PogValGen/robo-boxer/README.md

# robo-boxer — робот-боксёр на MG90S (ROBO-ONE Light)

Открытый DIY-проект миниатюрного двуногого робота-боксёра: сервоприводы MG90S, ШИМ-контроллер на 32 канала (в наличии RTrobot Sync 32 кан., skill `rtrobot`; в ТЗ — PCA9685 ×2), IMU MPU-6050, раздельное питание (BEC 5 В / 8–10 А). Исходное ТЗ: `docs/notes/2026-10-31_robo_one_boxing_spec.md`.

## Статус

| Узел | Состояние |
|---|---|
| Узел разгрузки сустава (685ZZ + ось 623ZZ, карман MG90S +0,2) | **v0.2** 2026-10-31 (рёбра + облегчение; v0.1 в `cad/joint_v01/`): `cad/joint/Joint_MG90S.SLDASM`, STL печатных деталей `cad/joint/stl/`, сценарий `scripts/build_joint.py` |
| Сервопривод MG90S | модель GrabCAD (`cad/purchased/`); гнездо 23,2×13,0 — подобрано пользователем (Голень.stl); качалка — типовые размеры (приняты); кабель выходит снизу из торца со стороны вала (фото Racerstar MG90S) (`docs/notes/mg90s_measure_checklist.md`) |
| Нога: бедро-крен H1 (повёрнут 90°) → бедро-тангаж → колено → голеностоп + стопа с грузом | **v0.1** 2026-10-31: `cad/leg/Leg_Pitch.SLDASM`, `scripts/build_leg.py` |
| Таз + поворот корпуса W + площадка торса; сборка низа робота | **v0.1** 2026-10-31: `cad/body/Robot_Lower.SLDASM`, `scripts/build_pelvis.py` |
| 3D-просмотр (Android/браузер) | `docs/viewer/robot_3d.html` ← `scripts/make_viewer.py` |
| Руки (S1 → S2 повёрнут → E + кулак TPU), плечевая перекладина, весь робот | **v0.1** 2026-10-31: `cad/arm/Arm.SLDASM`, `cad/body/Robot.SLDASM`, `scripts/build_arm.py` |
| Торс (оболочка), голова-бампер, электроника | не начато |
| Электроника, прошивка (IK, PD-баланс, UART) | не начато |

## Структура

- `cad/` — модели SolidWorks (детали, сборки, STL для печати)
- `scripts/` — сценарии построения через solidworks-mcp
- `docs/` — материалы (индекс `docs/MATERIALS.md`)

## Связанные проекты

- **solidworks-mcp** — инструменты построения (Toolbox, Hole Wizard, сопряжения).
- **pcb-kicad** — если понадобится своя плата распределения питания/ШИМ.

## Узел сустава v0.2 (2026-10-31)

Схема силового потока: удар по рычагу → цапфа Ø5 → 685ZZ в мосту → стойка корпуса; нижняя щека → штифт ISO 2338 3×8 → 623ZZ в бобышке корпуса. Вал сервы получает только момент через качалку, утопленную в карман щеки (+0,2).

| Деталь | Материал | Габарит, мм | Объём |
|---|---|---|---|
| Joint_Housing (гнездо MG90S, стойка с 2 рёбрами-косынками, бобышка 623, выборка снизу) | ABS/PETG | 38,5 × 43,6 × 18 | 9180 мм³ (v0.1: 9644) |
| Joint_Bridge (гнездо 685, 2×M2 к стойке, швеллер: рёбра 2,5 + дно 2,5) | ABS/PETG | 36,5 × 6,5 × 18 | 2655 мм³ (v0.1: 3435) |
| Joint_Lever (U-рычаг, цапфа Ø5, штифт, 4×M2, окно в нижней щеке, карман в верхней) | ABS/PETG | 35 × 53,1 × 14 | 5058 мм³ (v0.1: 5658) |
| Подшипники 685ZZ, 623ZZ; штифт 3×8 | Toolbox ISO 15 / ISO 2338 | — | — |

Итого печать 16,9 см³ (−10 % к v0.1): сплошной ABS ≈ 17,7 г, при обычной печати (3 периметра, 30 % заполнения) ≈ 11 г + подшипники/штифт ≈ 3 г. Качалка — типовые размеры, приняты пользователем.

Кабель: паз в торце со стороны вала → плоский канал 1,8 мм под сервой → выход в торце −x (сектор, куда рычаг не заходит).

Сборка узла (v0.3): 1) MG90S в гнездо, саморезы M2 в ушки; 2) рычаг сначала прикрутить к торцу СЛЕДУЮЩЕГО корпуса (4 винта M2 с внутренним шестигранником изнутри U, пока U пустой); 3) качалку вложить в карман щеки и прикрутить 2 саморезами; 4) рычаг с качалкой надвинуть сбоку на 3,6 мм выше вала, опустить на шлицы (центральный винт качалки не нужен — рычаг зажат между подшипниками); 5) 623 запрессовать в бобышку, штифт 3×12 снизу через щеку в 623; 6) 685 в мост, мост на цапфу, 2×M2 в стойку. Ход ≈ ±140°.

## Нога v0.1 (2026-10-31)

Три узла в линию (бедро-тангаж H2, колено K, голеностоп A), шаг осей **55,5 мм**: перемычка рычага = торец следующего корпуса. Стопа 80 × 52 × 8 (ABS) на рычаге голеностопа, снизу карман под стальной груз **60 × 40 × 3** (≈56 г, на клей). От оси бедра до подошвы 147 мм. Пересечений нет (только касания ушек сервы). Бедро-крен H1 — тот же узел, повёрнут на 90° (стык 4×M2 квадратом ±4,5 подходит при повороте). Все 4 узла — один файл `Joint_MG90S.SLDASM`: правка узла сразу во всех. Дальше: таз (крепление H1 обеих ног + поворот W).

## Низ робота v0.1 (2026-10-31)

Система координат робота = ноги: x вниз, y вбок, z вперёд. Ноги на y = ±50 (стойка 100 мм). Таз: плита 124 × 52 × 6, к узлам H1 по 4×M2 сверху (Hole Wizard); сзади стойка с 2 косынками, на ней узел W (ось вертикальна), винты 4×M2 сзади. На рычаге W — площадка торса 90 × 67 (Г-образная). Всего 9 узлов = 9 × MG90S. Пересечений нет (18 касаний ушек сервы, объём 0).

3D: `python scripts\make_viewer.py` → HTML с three.js внутри (6 МБ), открывается на телефоне без интернета; положения деталей сверены с SolidWorks (76/76).

## Робот целиком v0.1 (2026-10-31)

15 узлов = 15 × MG90S (ноги 2 × 4, W, руки 2 × 3). Перекладина плеч 256 × 52 × 6 на площадке торса (4×M2), плечи на y = ±116 (ближе — руки задевают ноги). Рука: S1 (тангаж) → S2 (крен, узел повёрнут 90°) → локоть E → кулак TPU 30 × 32 × 32 (R6). Пересечений нет (30 касаний ушек, объём 0). Габарит ≈ 290 (ширина) × 310 (высота) мм — ширину даёт узел (60 мм по оси); резерв: повернуть S1 так, чтобы узел стоял узкой стороной.
