PogValGen/robo-boxer/docs/notes/2026-10-31_robo_one_boxing_spec.md

# Техническая документация: Проект антропоморфного робота-боксера на базе сервоприводов MG90S

## 1. Введение и концепция проекта
Данный документ обобщает технические решения, архитектурные концепции и спецификации для создания открытого DIY-проекта миниатюрного двуногого робота-боксера (гуманоида/полугуманоида). Проект адаптирован под жесткие ограничения соревнований класса **ROBO-ONE / ROBO-ONE Light**, регламентирующих вес, габариты и автономность мобильных человекоподобных роботов.

**Ключевая цель проекта:** Создание устойчивого, ударопрочного робота для ведения ближнего боя (бокс/ближний захват), способного наносить динамические удары за счет инерции корпуса и сохранять равновесие при встречных столкновениях.

---

## 2. Аппаратная спецификация (BOM & Электроника)
Для реализации системы используется готовый сетап комплектующих начального и полупрофессионального уровня:

*   **Силовые приводы (Сервоприводы):** Цифровые микросервоприводы **MG90S** (9g, металлический редуктор, крутящий момент ~1.8–2.2 кгф·см при 4.8V–6.0V). 
*   **Управляющий контроллер:** Специализированная плата расширения на **32 канала** управления ШИМ (PWM/Servo driver, например, на базе каскада микросхем PCA9685 или автономного USB/UART контроллера).
*   **Датчики стабилизации:** IMU-сенсор (гироскоп + акселерометр) **MPU-6050**, подключенный по шине I2C к мастер-контроллеру для вычисления углов наклона и динамического удержания баланса в реальном времени.
*   **Система питания:** Силовые цепи сервоприводов изолированы от цепей питания логики микроконтроллера. Рекомендуется выделенный DC-DC импульсный понижающий преобразователь (BEC) с параметрами **5V / 8-10A** пикового тока.

---

## 3. Кинематическая схема робота-боксера
Для компенсации невысокого крутящего момента сервоприводов MG90S классическая антропоморфная геометрия изменена в пользу «приземистого» полугуманоидного шасси с низким центром тяжести.

### Распределение степеней свободы (DoF):
1.  **Торс и таз (1 DoF):** Сервопривод скручивания корпуса влево/вправо в плоскости горизонта. Обеспечивает передачу момента от ног к плечевому поясу для генерации силы удара (хуки/апперкоты).
2.  **Плечевой узел (2 DoF на руку):** 
    *   *Ось X:* Подъем/опускание всей руки (апперкоты, защита головы).
    *   *Ось Y:* Выброс руки вперед (прямые удары, джебы).
3.  **Локтевой сустав (1 DoF на руку):** Сгибание предплечья для удержания боксерской стойки и блокирования ударов соперника.
4.  **Нижнее шасси (Ноги, 6–8 DoF):** Укороченные рычаги бедер и голеней, широкая расстановка стоп (Wide Stance) для пассивной поперечной устойчивости.

---

## 4. Защита механизмов и 3D-печать (SolidWorks CAD)
Главная инженерная уязвимость сервоприводов MG90S при ударных нагрузках — хрупкость выходного вала (4.8 мм) и пластиковых проушин корпуса. Вся ударная волна от кулака робота должна уходить на внешний силовой каркас, минуя редуктор мотора.

### Техническое задание для моделирования узла разгрузки в SolidWorks:
*   **Соосная разгрузка вала:** Деталь плеча/предплечья базируется на силовом радиальном мини-подшипнике (например, **685ZZ** с внутренним диаметром 5 мм или **623ZZ**), запрессованном в печатный стакан корпуса. Вал сервопривода соединяется с деталью исключительно через гибкую шлицевую муфту (качалку), передавая только вращательный момент.
*   **Опорная точка (Ленивец):** На противоположной стороне сустава проектируется соосная гладкая ось вращения (простой штифт или второй подшипник) для предотвращения перекосов и скручивания конструкции при боковых ударах.
*   **FDM Допуски под печать:** Номинальные размеры кармана под установку MG90S в SolidWorks закладываются с технологическим зазором **+0.2 мм** на каждую сторону (для компенсации усадки пластиков ABS/PETG).
*   **Снижение веса и демпфирование:**
    *   Верхняя часть корпуса (торс, руки) моделируется с тонкими стенками (2-2.5 мм) и внутренними ребрами жесткости (*Ribs*).
    *   Кулаки и защитные накладки проектируются под печать гибкими пластиками (**TPU/Flex**) для гашения энергии встречного удара.
    *   Элементы стоп утяжеляются металлическими закладными элементами (гарантия эффекта «неваляшки»).

---

## 5. Программный уровень и алгоритмы
*   **Инверсная кинематика (IK):** Расчет траектории перемещения стоп для плавного шага без отрыва центра тяжести от опорной площади.
*   **Система стабилизации:** Коррекция ШИМ-сигналов на сервоприводы голеностопа по пропорционально-дифференциальному (PD) алгоритму на основе данных угловых скоростей с MPU-6050.
*   **Интерфейс управления:** Движения активируются по протоколу UART (последовательные команды) через Bluetooth-модуль или внешний контроллер верхнего уровня.
