PogValGen/robo-boxer/docs/notes/2026-10-31_mg90s_dimensions_sources.md

# MG90S — источники размеров (2026-10-31)

Официального механического чертежа TowerPro MG90S в открытом доступе не найдено.

| Параметр | Значение | Источник | Статус |
|---|---|---|---|
| Корпус L×W×H | 22,8 × 12,2 × 28,5 мм | GetFPV, CoolComponents (большинство продавцов) | проверить |
| Корпус (альт.) | 22,5 × 12 × 35,5 мм | Controllerstech (вероятно, с валом) | расхождение |
| Крепёжные отверстия | 2 × M2, шаг ~8 мм (?) | блог KPower — вторичный | НЕ подтверждено |
| Вал | Ø4,8 мм (шлицы) | ТЗ пользователя | проверить число зубьев |
| Совместимость | «крепёж как у SG90» | ReadyMadeRC | не подтверждено |

URL:
- https://www.getfpv.com/towerpro-mg90s-digital-servo.html
- https://coolcomponents.co.uk/products/mg90s-analog-metal-gear-servo
- https://shop.controllerstech.com/products/mg90s-metal-gear-9g-digital-servo-motor-180-deg
- https://blog.kpower.com/servo/631.html
- https://readymaderc.com/products/details/86506-towerpro-mg90s-metal-gear-servo-90-degree-rotation

Вывод: модель MG90S параметрическая (`cad/mg90s_params.json`), всё помечено `verify`; окончательные размеры — по замеру (чеклист `mg90s_measure_checklist.md`).
