PogValGen/robo-boxer/cad/joint/screens/asm_front.png

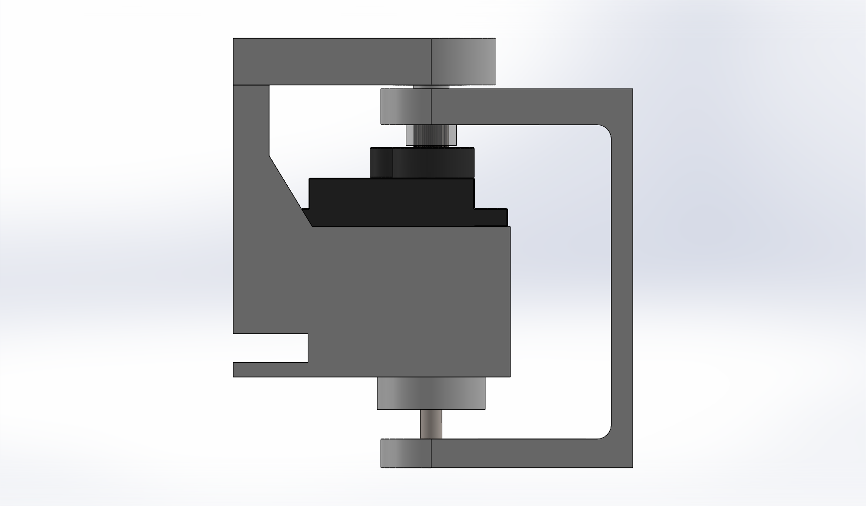
cad/joint/screens/asm_front.png
