PogValGen/robo-boxer/cad/joint/screens/asm_right.png

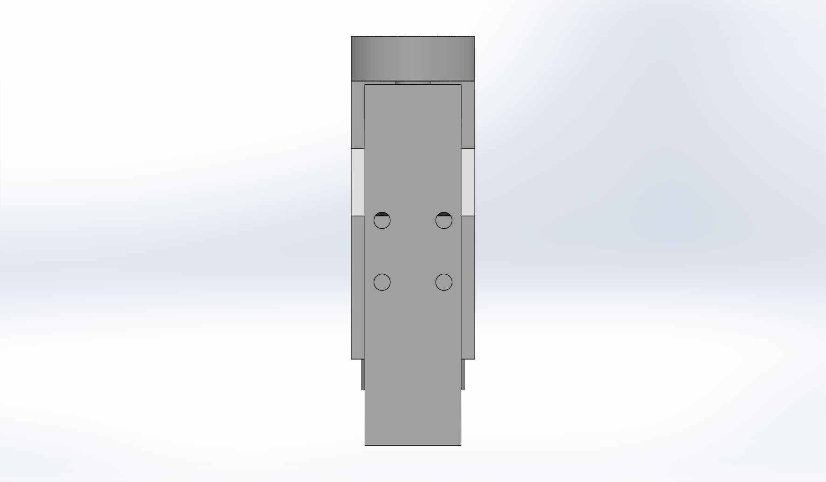
cad/joint/screens/asm_right.png
