PogValGen/robo-boxer/cad/joint/screens/asm_top.png

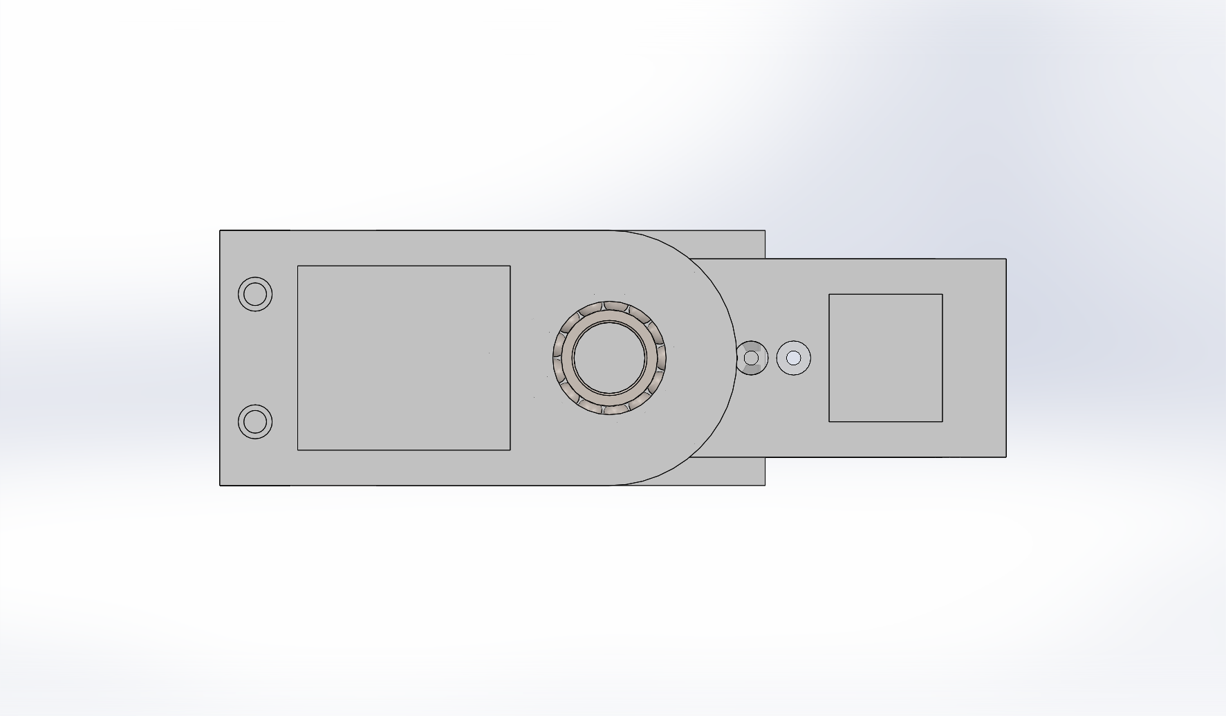
cad/joint/screens/asm_top.png
