PogValGen/robo-boxer/cad/joint/screens/bridge_iso.png

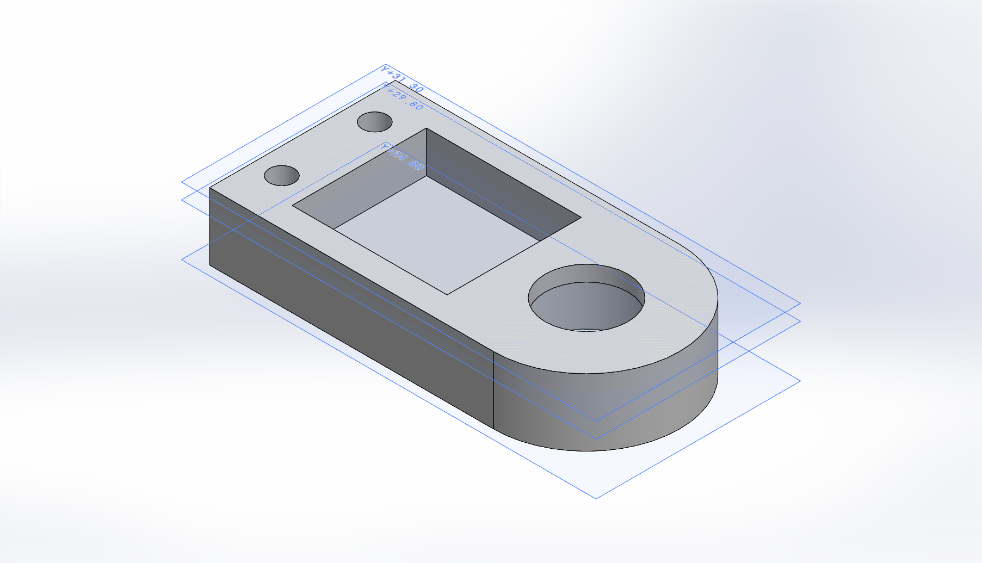
cad/joint/screens/bridge_iso.png
