PogValGen/robo-boxer/cad/joint/screens/fist_iso.png

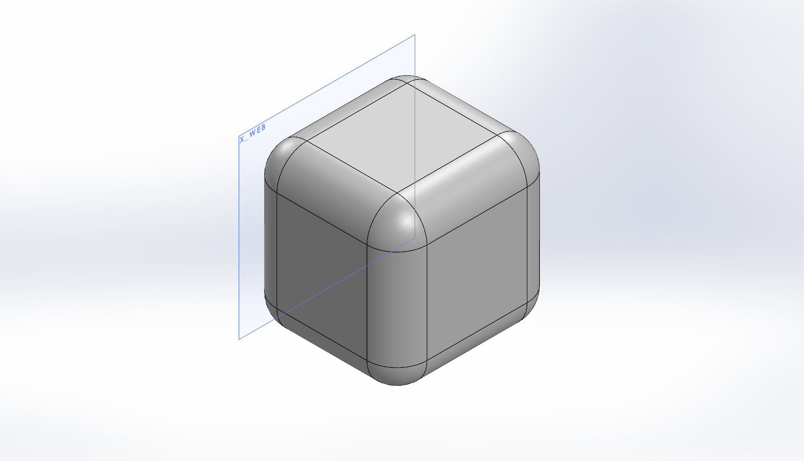
cad/joint/screens/fist_iso.png
