PogValGen/robo-boxer/cad/joint/screens/foot_iso.png

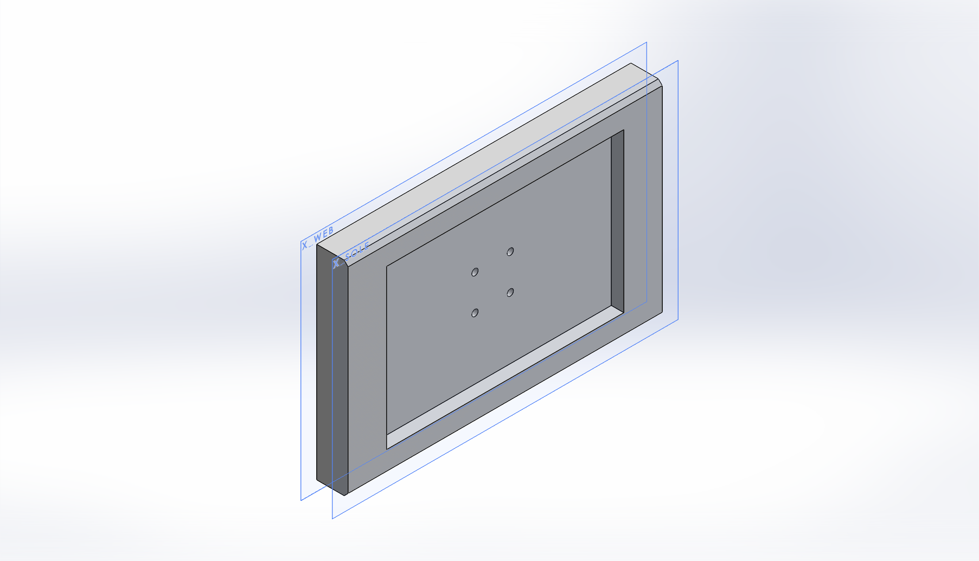
cad/joint/screens/foot_iso.png
