PogValGen/robo-boxer/cad/joint/screens/horn_iso.png

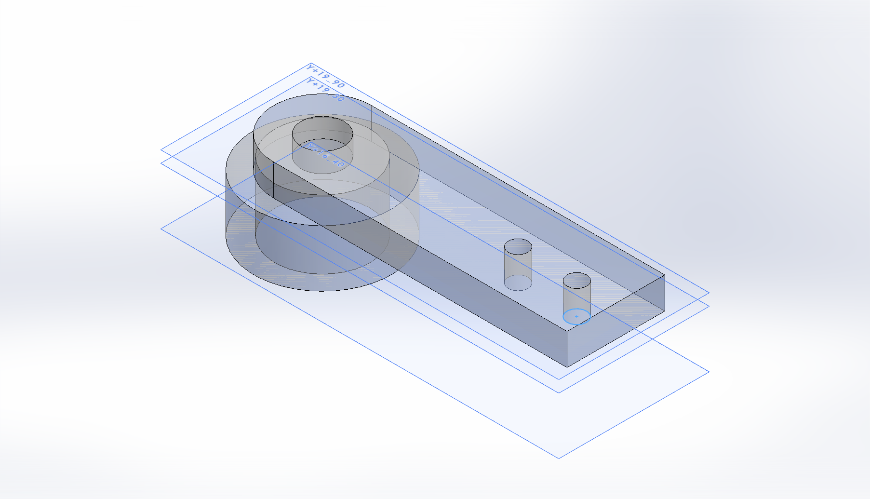
cad/joint/screens/horn_iso.png
