PogValGen/robo-boxer/cad/joint/screens/leg_front.png

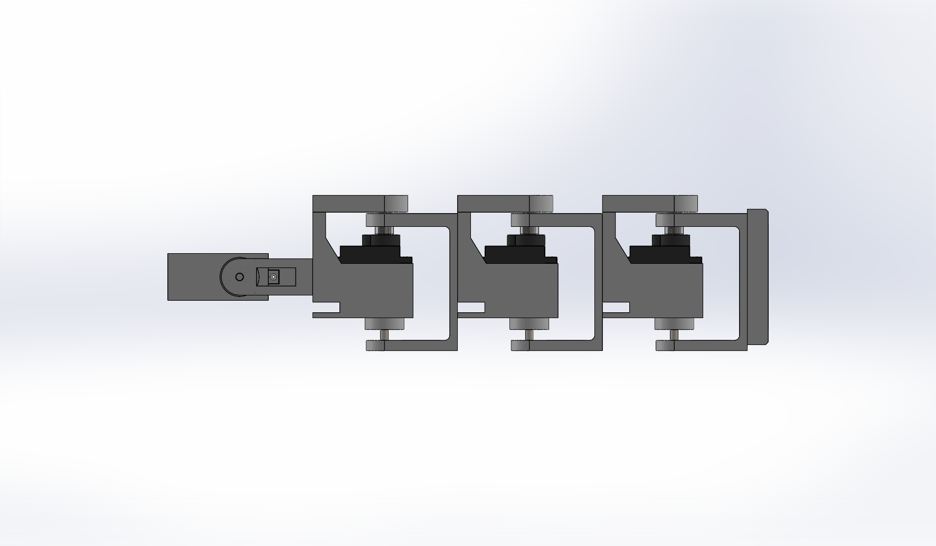
cad/joint/screens/leg_front.png
