PogValGen/robo-boxer/cad/joint/screens/leg_isometric.png

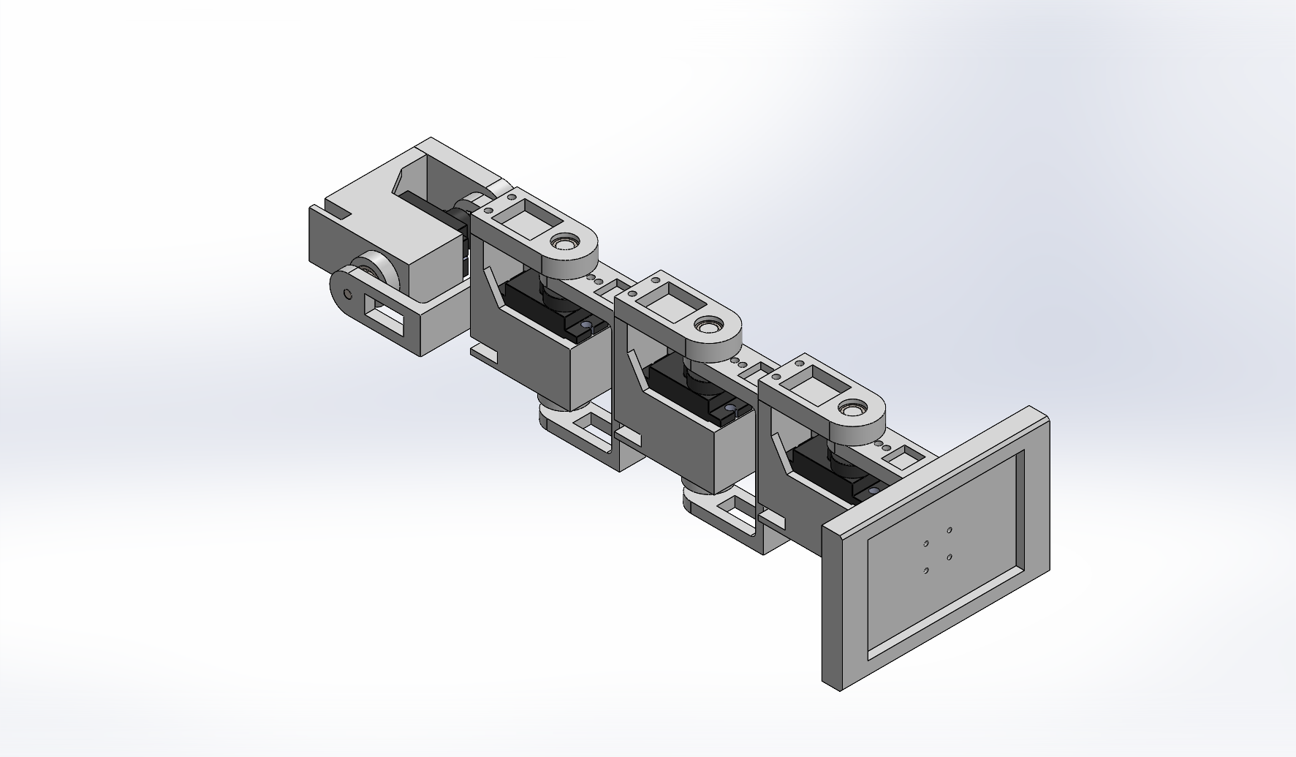
cad/joint/screens/leg_isometric.png
