PogValGen/robo-boxer/cad/joint/screens/leg_right.png

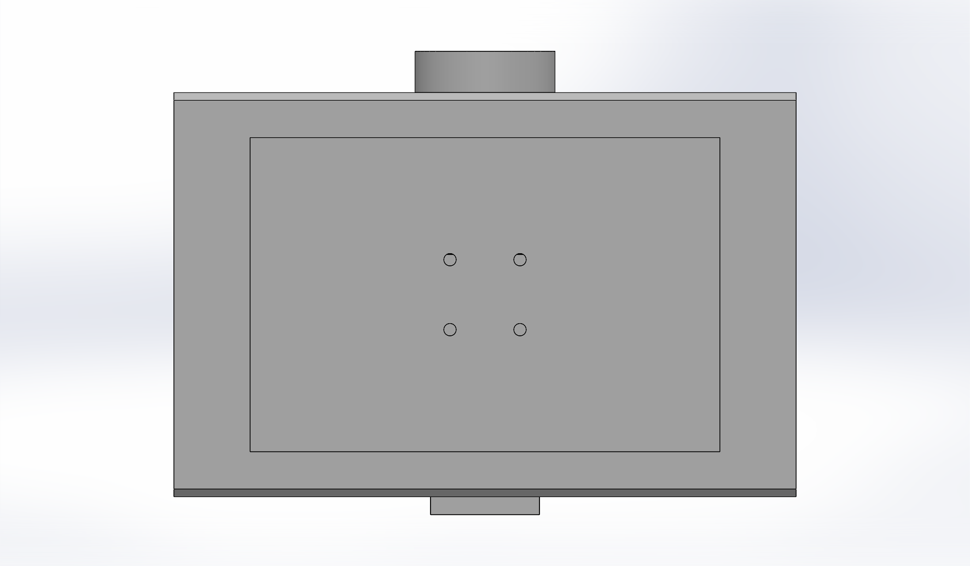
cad/joint/screens/leg_right.png
