PogValGen/robo-boxer/cad/joint/screens/leg_top.png

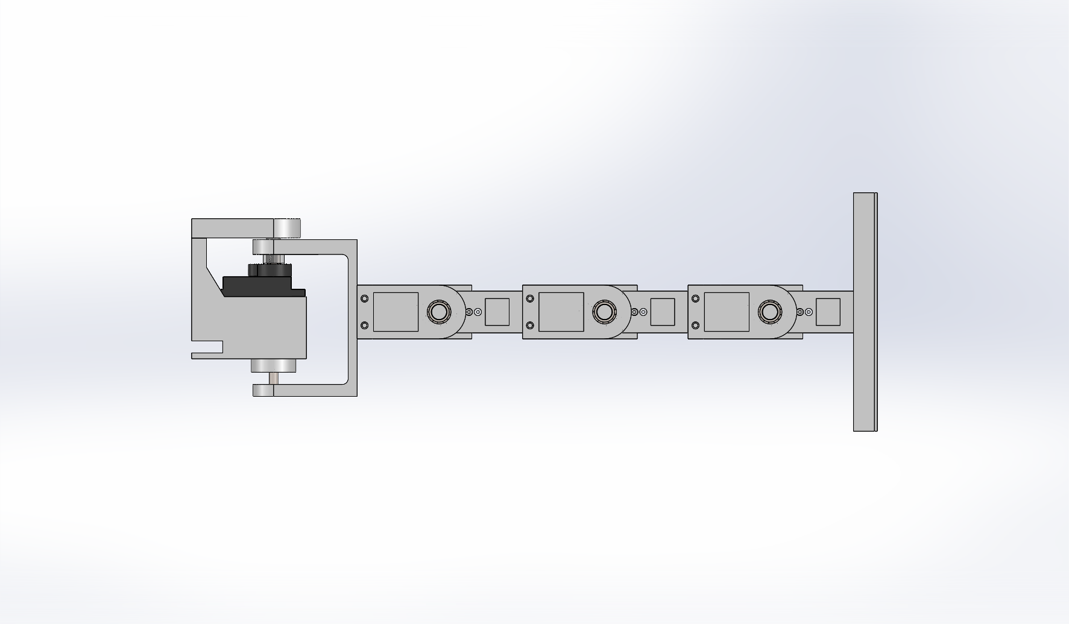
cad/joint/screens/leg_top.png
