PogValGen/robo-boxer/cad/joint/screens/lever_iso.png

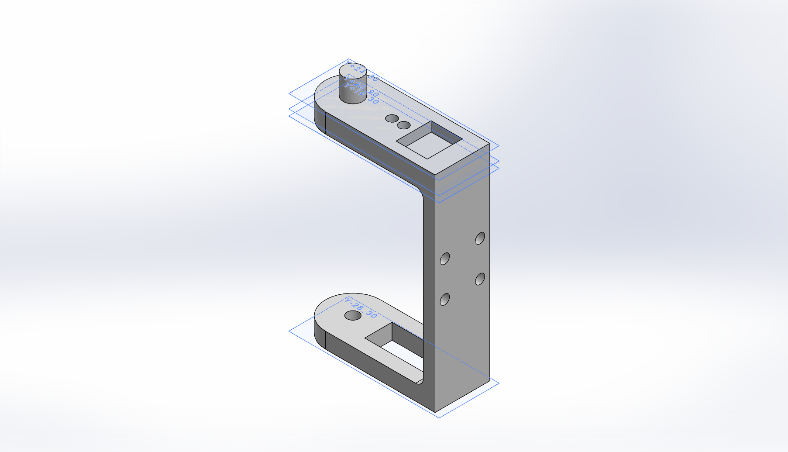
cad/joint/screens/lever_iso.png
