PogValGen/robo-boxer/cad/joint/screens/lower_front.png

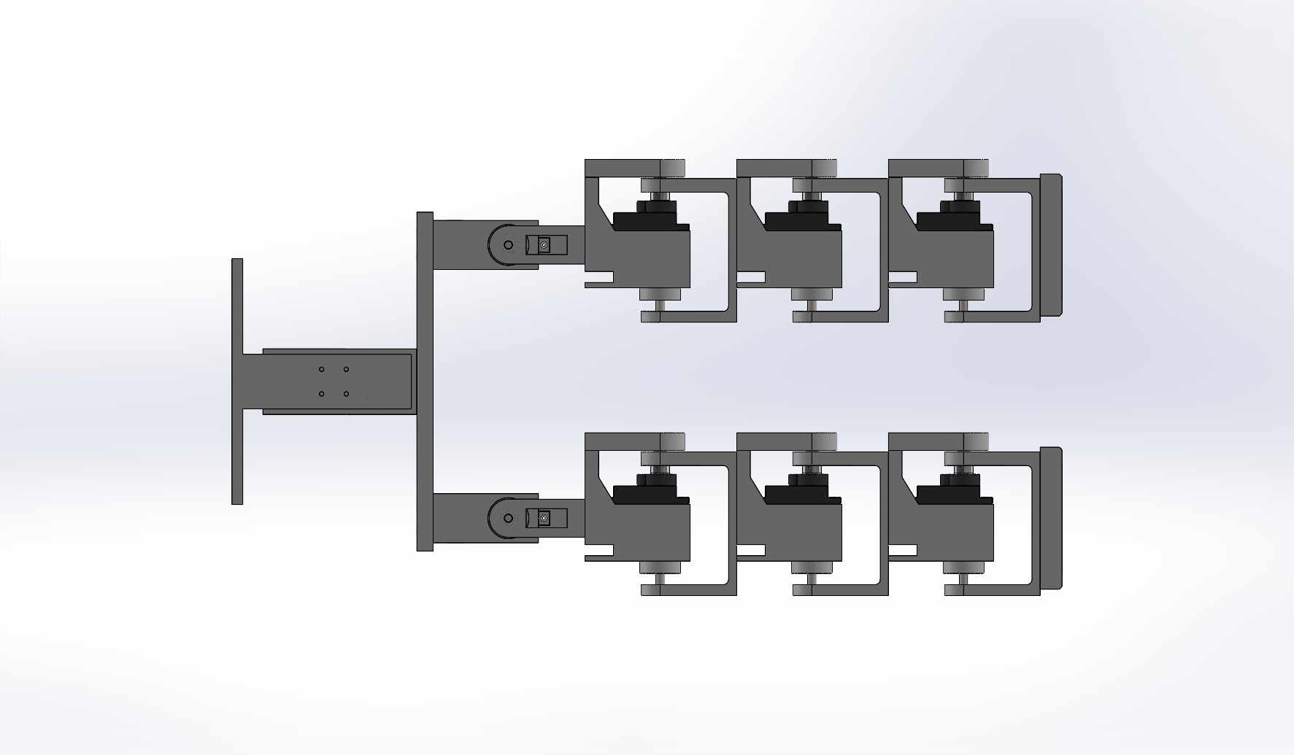
cad/joint/screens/lower_front.png
