PogValGen/robo-boxer/cad/joint/screens/lower_top.png

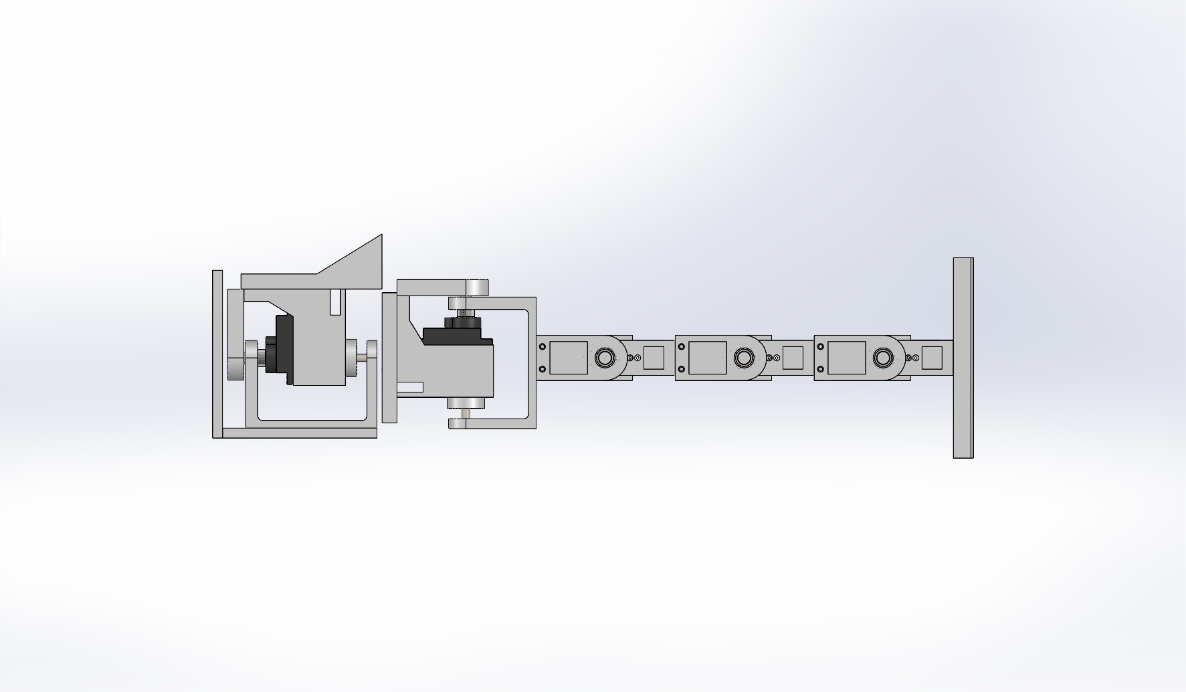
cad/joint/screens/lower_top.png
