PogValGen/robo-boxer/cad/joint/screens/pelvis_iso.png

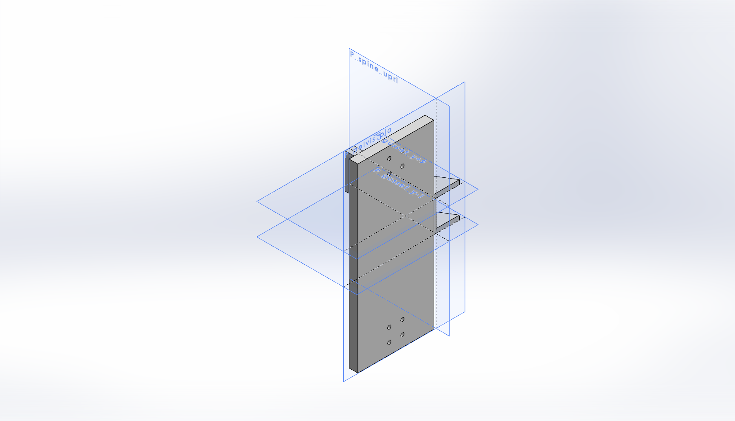
cad/joint/screens/pelvis_iso.png
