PogValGen/robo-boxer/cad/joint/screens/probe_hw_5.0.png

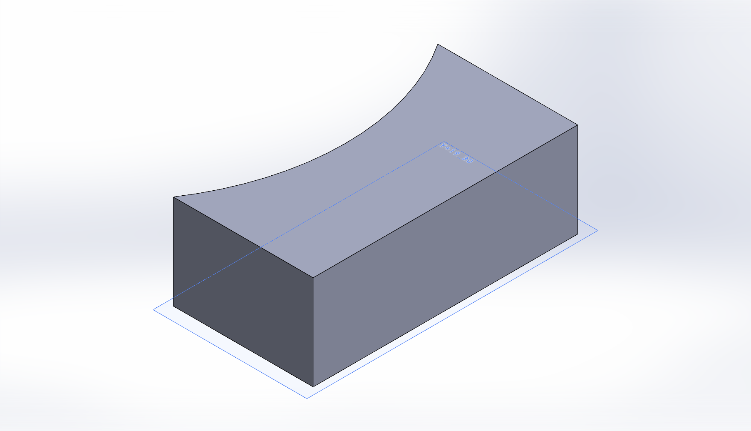
cad/joint/screens/probe_hw_5.0.png
