PogValGen/robo-boxer/cad/joint/screens/probe_pocket.png

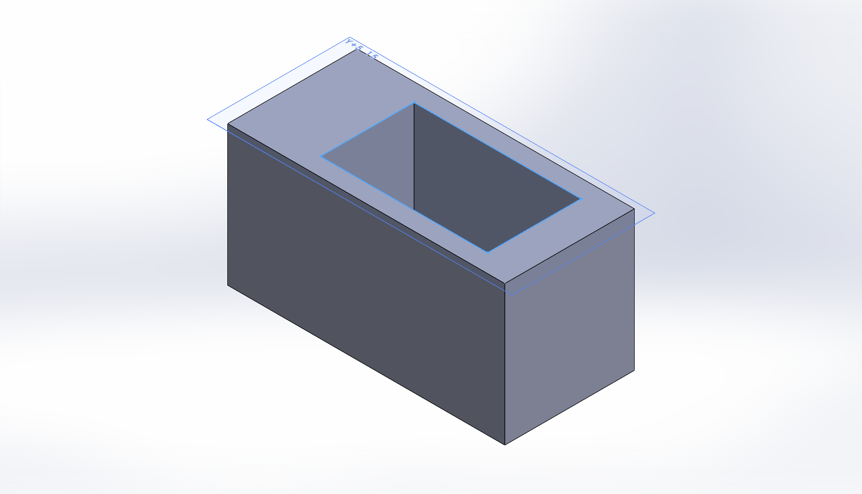
cad/joint/screens/probe_pocket.png
