PogValGen/robo-boxer/cad/joint/screens/robot_front.png

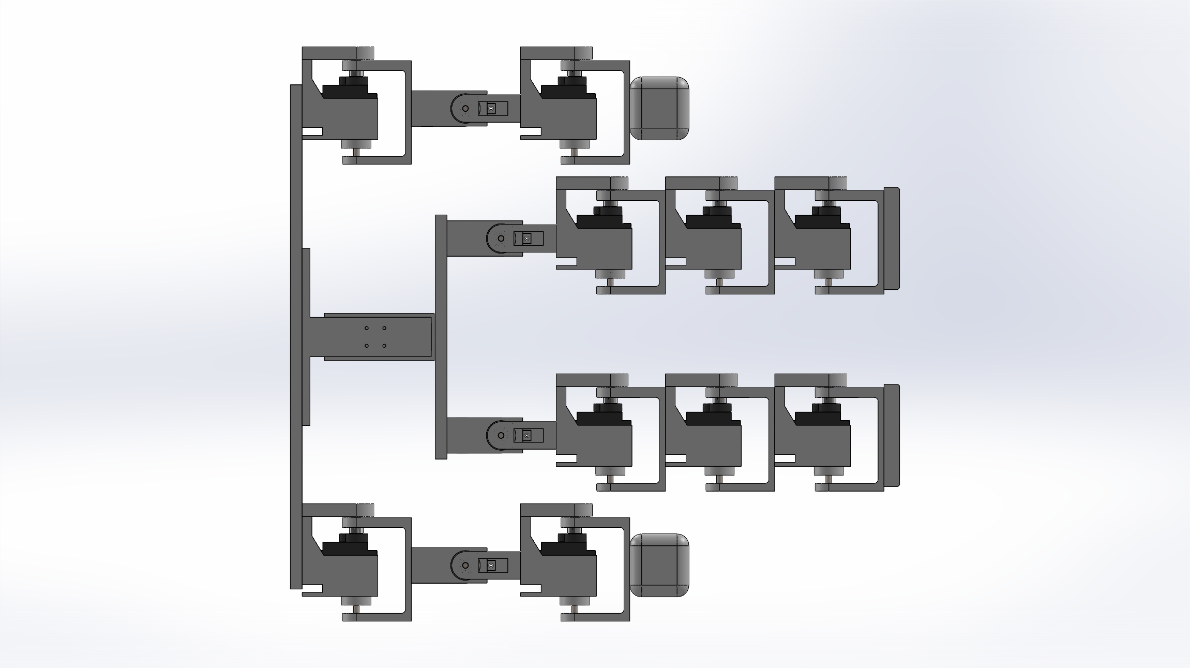
cad/joint/screens/robot_front.png
