PogValGen/robo-boxer/cad/joint/screens/robot_isometric.png

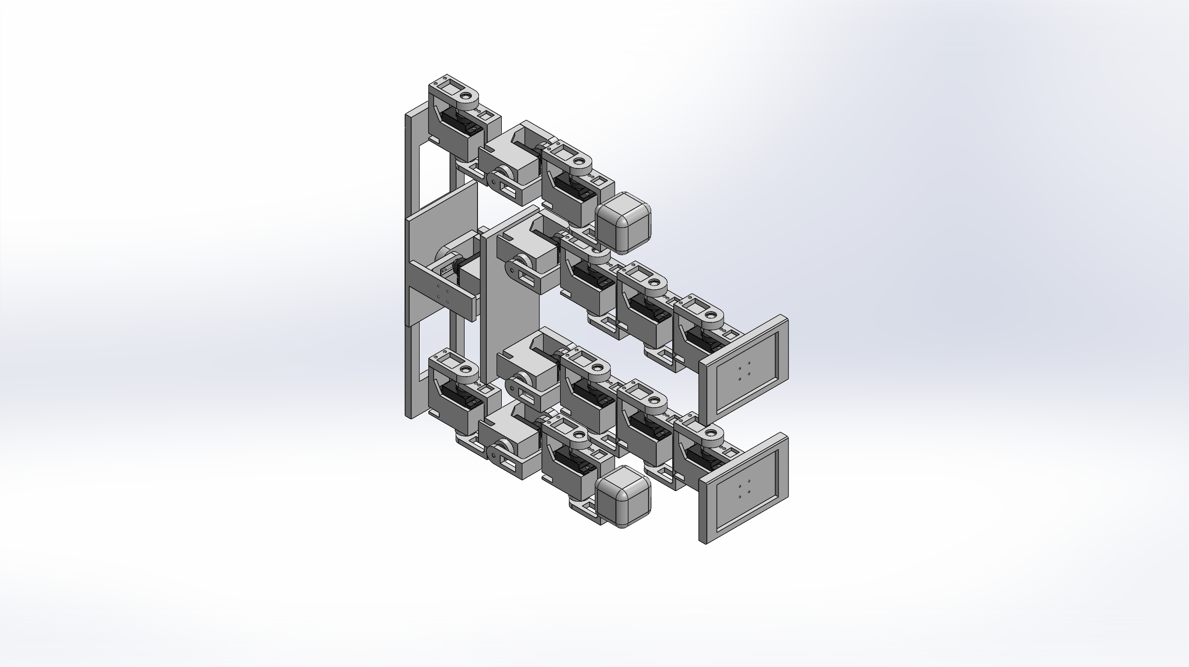
cad/joint/screens/robot_isometric.png
