PogValGen/robo-boxer/cad/joint/screens/robot_right.png

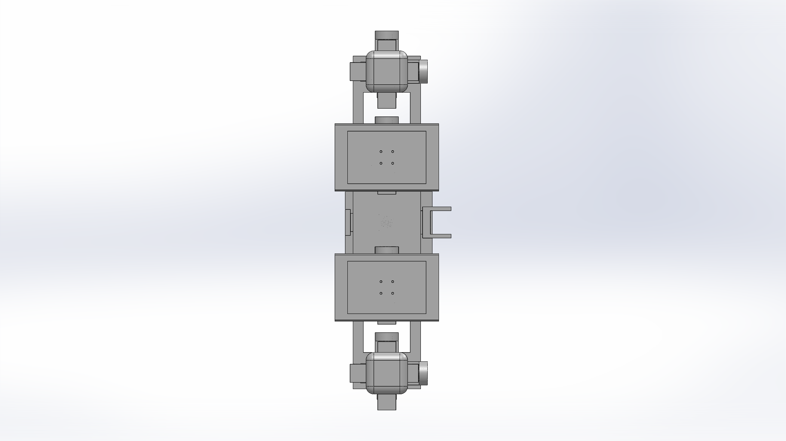
cad/joint/screens/robot_right.png
