PogValGen/robo-boxer/cad/joint/screens/torso_mount_iso.png

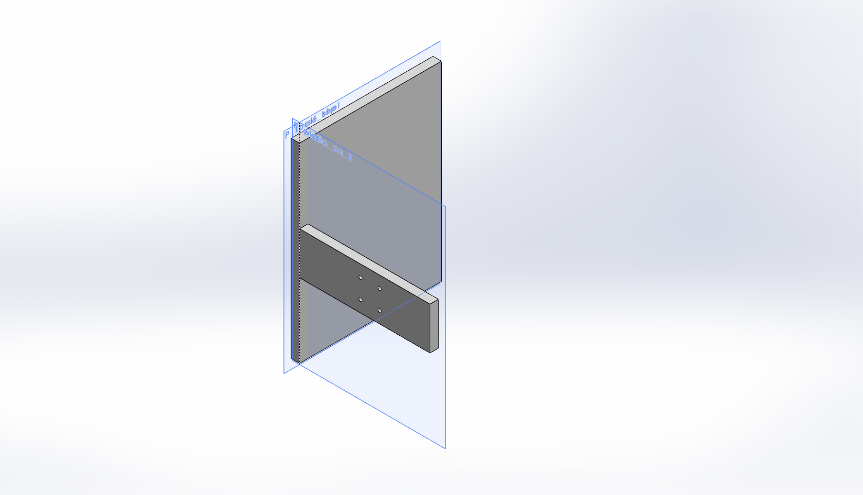
cad/joint/screens/torso_mount_iso.png
