PogValGen/robo-boxer/cad/joint_v01/screens/bridge_iso.png

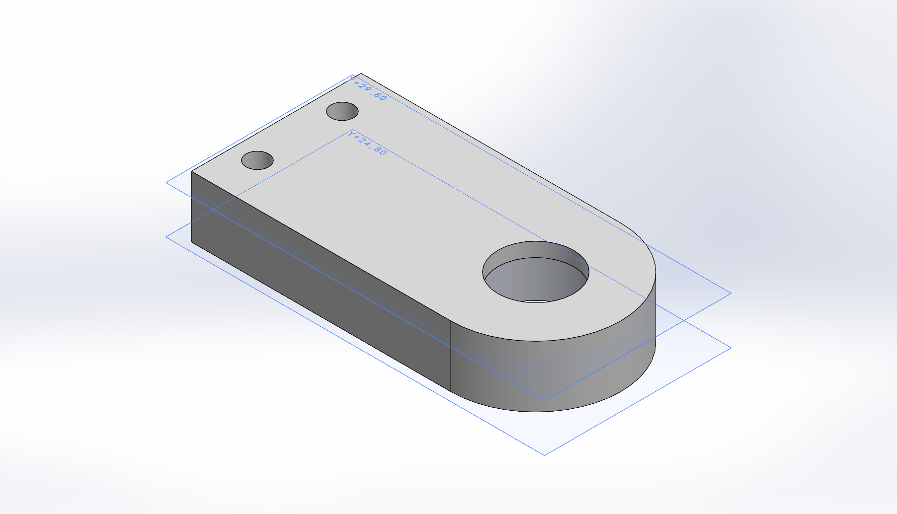
cad/joint_v01/screens/bridge_iso.png
