PogValGen/robo-boxer/cad/joint_v01/screens/housing_iso.png

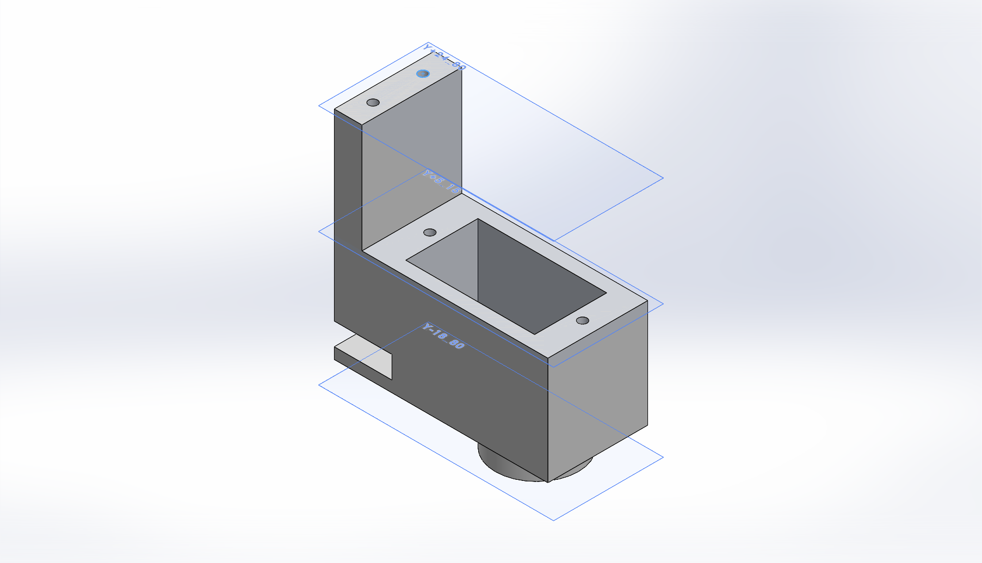
cad/joint_v01/screens/housing_iso.png
