PogValGen/robo-boxer/docs/concept/concept_v01.png

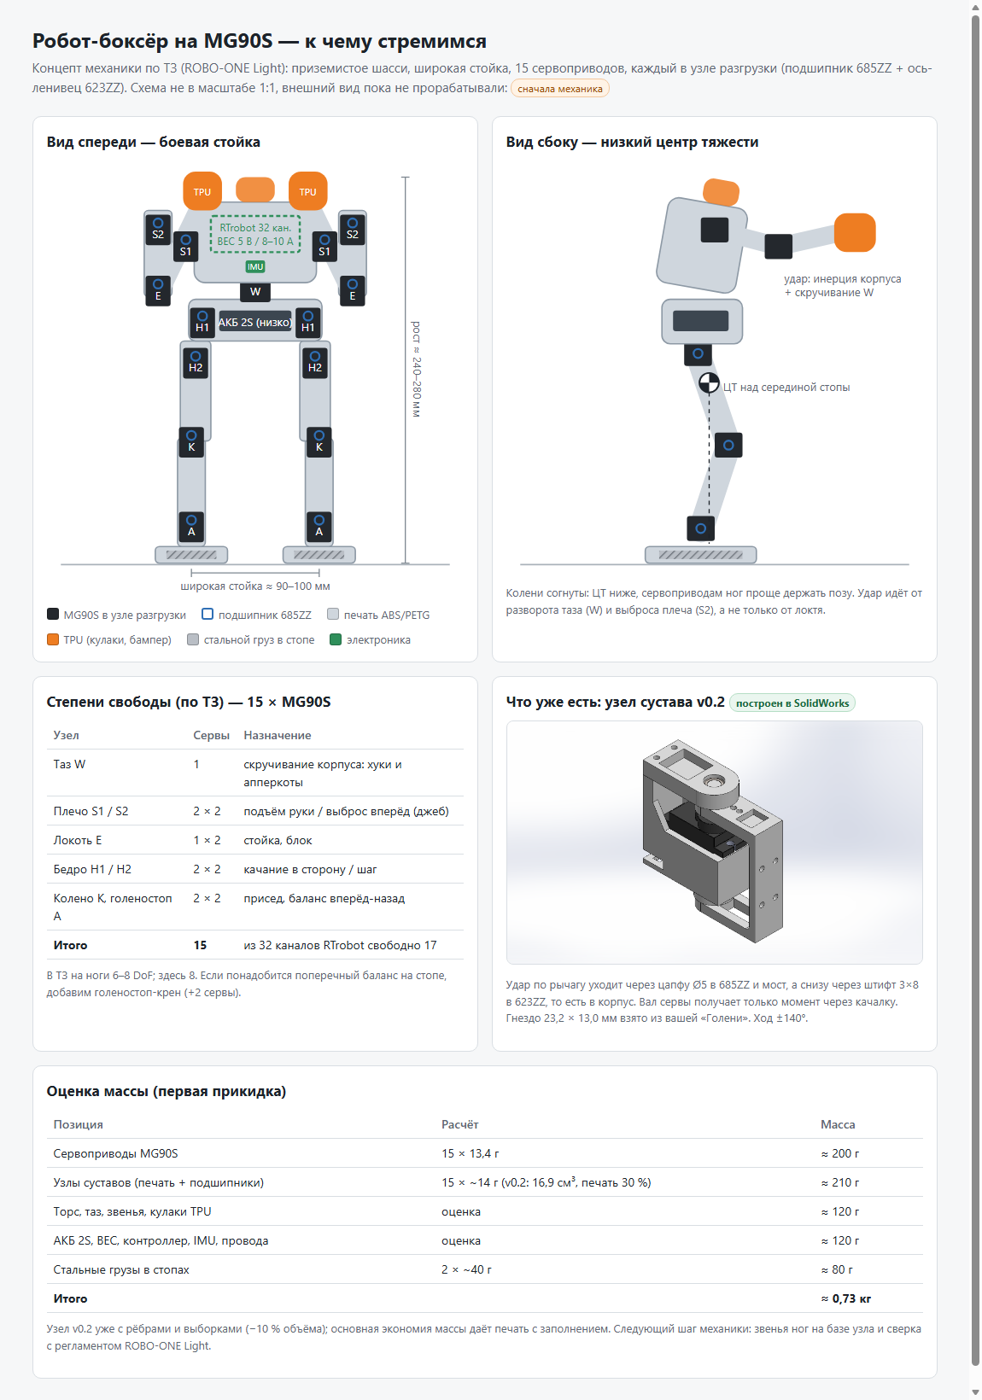
docs/concept/concept_v01.png
