PogValGen/robo-boxer/cad/arm/Arm.SLDASM

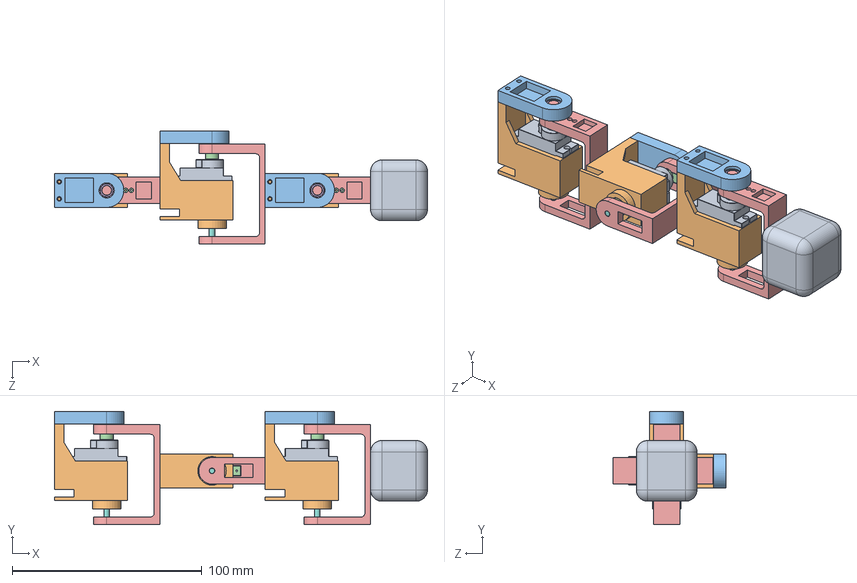
[picture p26: CAD file, 2026-10-31]
cad/arm/Arm.SLDASM
196.5 x 59.6 x 59.6 mm
MG90S_grabcad x 3
Joint_Housing x 3
Joint_Bridge x 3
MG90S_Horn x 3
Joint_Lever x 3
Bearing_685ZZ x 3
Bearing_623ZZ x 3
Pin_ISO2338_3x12 x 3
Fist_TPU
