PogValGen/robo-boxer/cad/body/Robot_Lower.SLDASM

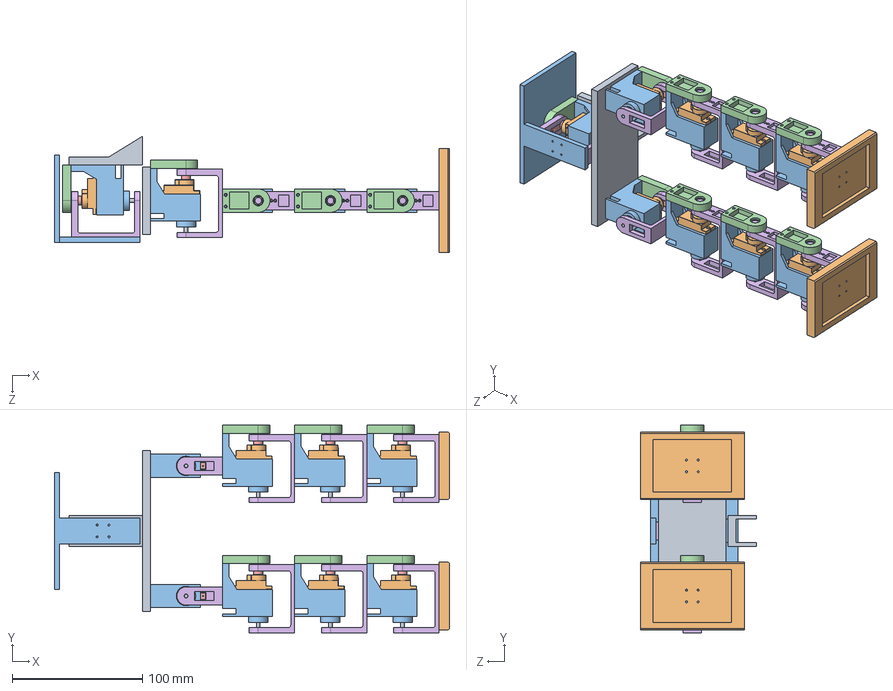
[picture p27: CAD file, 2026-10-31]
cad/body/Robot_Lower.SLDASM
303.6 x 159.6 x 89.5 mm
Pelvis
MG90S_grabcad x 9
Joint_Housing x 9
Joint_Bridge x 9
MG90S_Horn x 9
Joint_Lever x 9
Bearing_685ZZ x 9
Bearing_623ZZ x 9
Pin_ISO2338_3x12 x 9
Leg_Foot x 2
Torso_Mount
