PogValGen/robo-boxer/cad/leg/Leg_Pitch.SLDASM

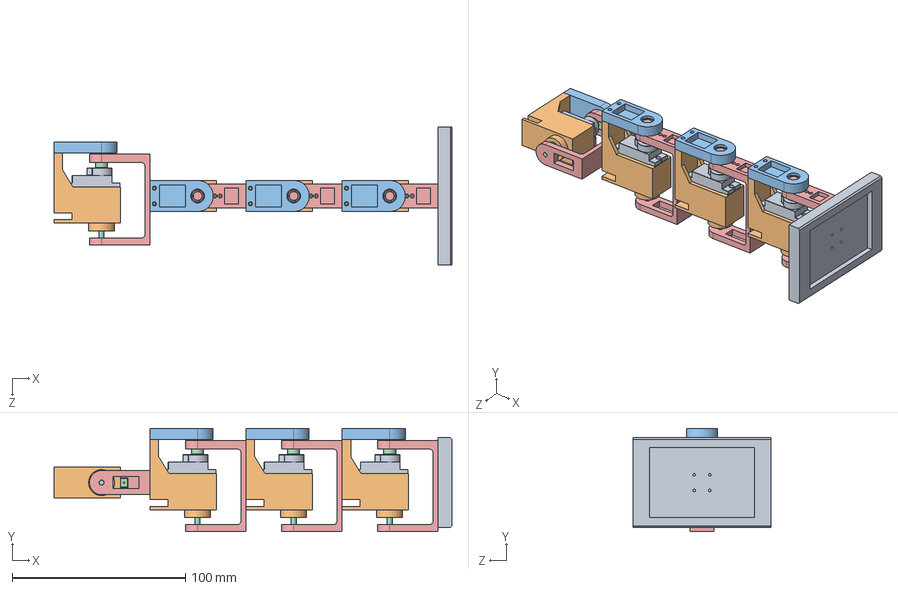
[picture p28: CAD file, 2026-10-31]
cad/leg/Leg_Pitch.SLDASM
230.0 x 59.6 x 80.0 mm
MG90S_grabcad x 4
Joint_Housing x 4
Joint_Bridge x 4
MG90S_Horn x 4
Joint_Lever x 4
Bearing_685ZZ x 4
Bearing_623ZZ x 4
Pin_ISO2338_3x12 x 4
Leg_Foot
