PogValGen/robo-boxer/cad/joint_v01/Joint_MG90S.SLDASM

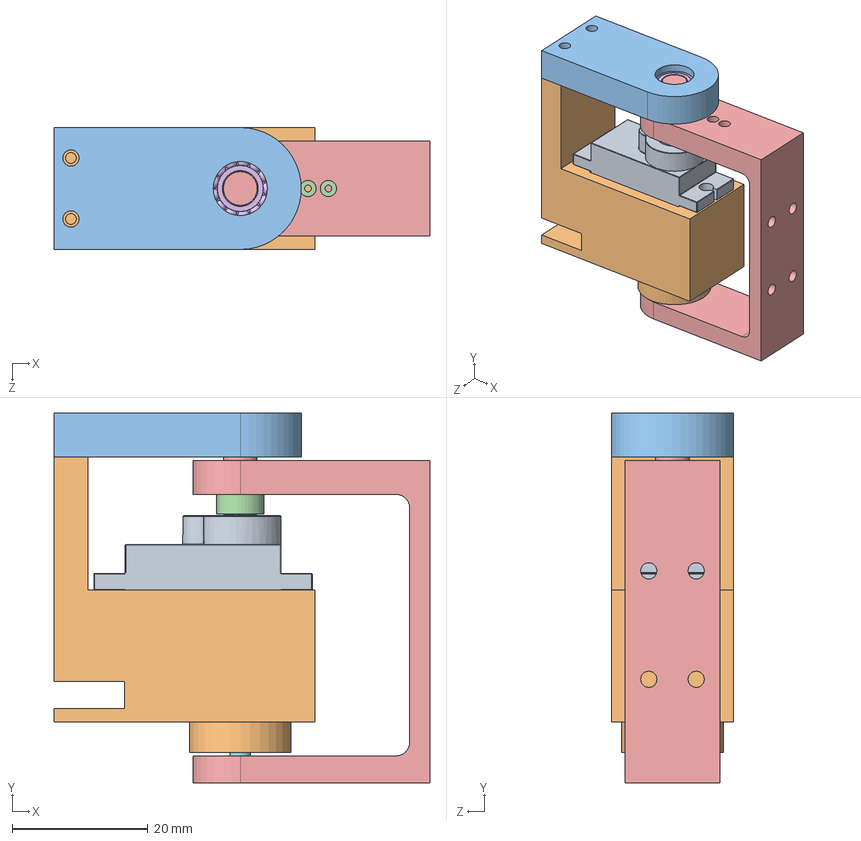
[picture p29: CAD file, 2026-10-31]
cad/joint_v01/Joint_MG90S.SLDASM
55.5 x 54.6 x 18.0 mm
MG90S_grabcad
Joint_Housing
Joint_Bridge
MG90S_Horn
Joint_Lever
Bearing_685ZZ
Bearing_623ZZ
Pin_ISO2338_3x8
