PogValGen/robo-boxer/cad/body/Robot.SLDASM

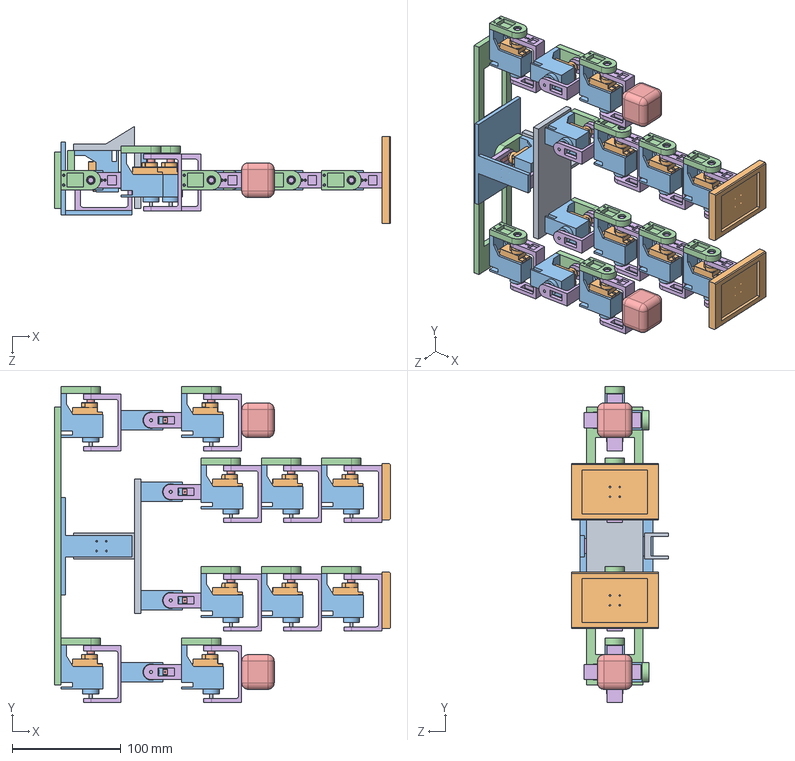
[picture p30: CAD file, 2026-10-31]
cad/body/Robot.SLDASM
309.6 x 291.6 x 89.5 mm
Pelvis
MG90S_grabcad x 15
Joint_Housing x 15
Joint_Bridge x 15
MG90S_Horn x 15
Joint_Lever x 15
Bearing_685ZZ x 15
Bearing_623ZZ x 15
Pin_ISO2338_3x12 x 15
Leg_Foot x 2
Torso_Mount
Shoulder_Yoke
Fist_TPU x 2
