PogValGen/robo-boxer/cad/joint/Joint_MG90S.SLDASM

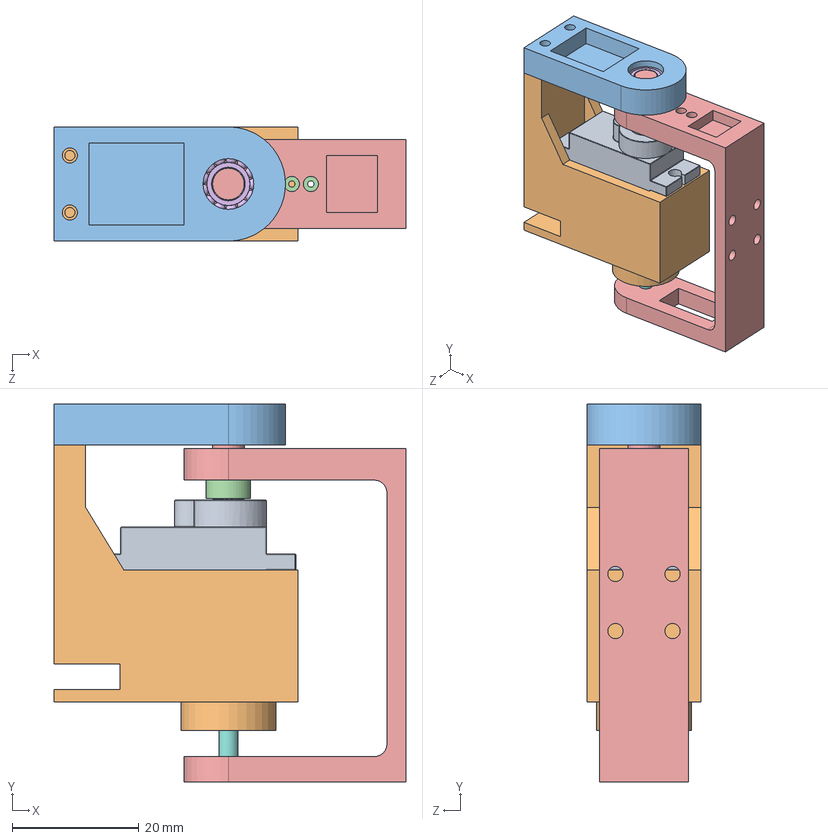
[picture p31: CAD file, 2026-10-31]
cad/joint/Joint_MG90S.SLDASM
55.5 x 59.6 x 18.0 mm
MG90S_grabcad
Joint_Housing
Joint_Bridge
MG90S_Horn
Joint_Lever
Bearing_685ZZ
Bearing_623ZZ
Pin_ISO2338_3x12
