PogValGen/robo-boxer/cad/joint/MG90S_Horn.SLDPRT

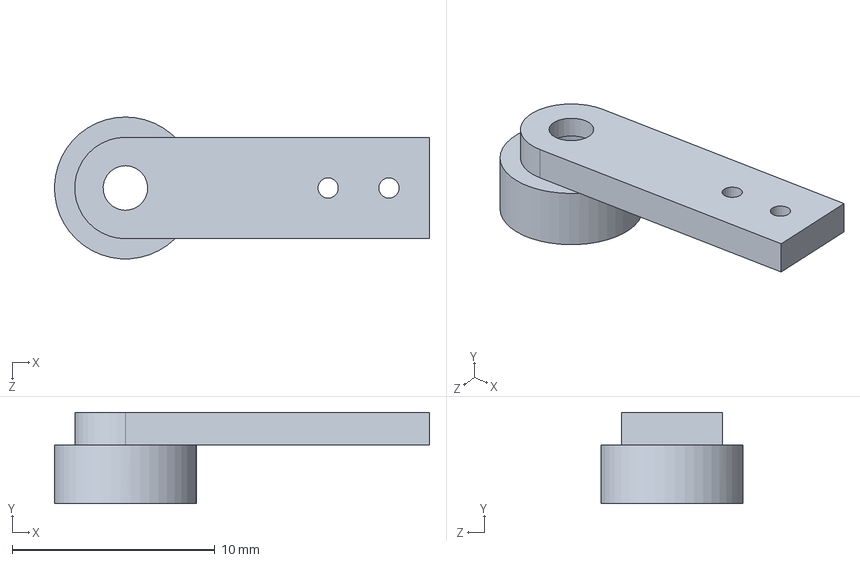
[picture p32: CAD file, 2026-10-31]
cad/joint/MG90S_Horn.SLDPRT
18.5 x 4.50 x 7.00 mm
