PogValGen/robo-boxer/cad/joint_v01/Joint_Housing.SLDPRT

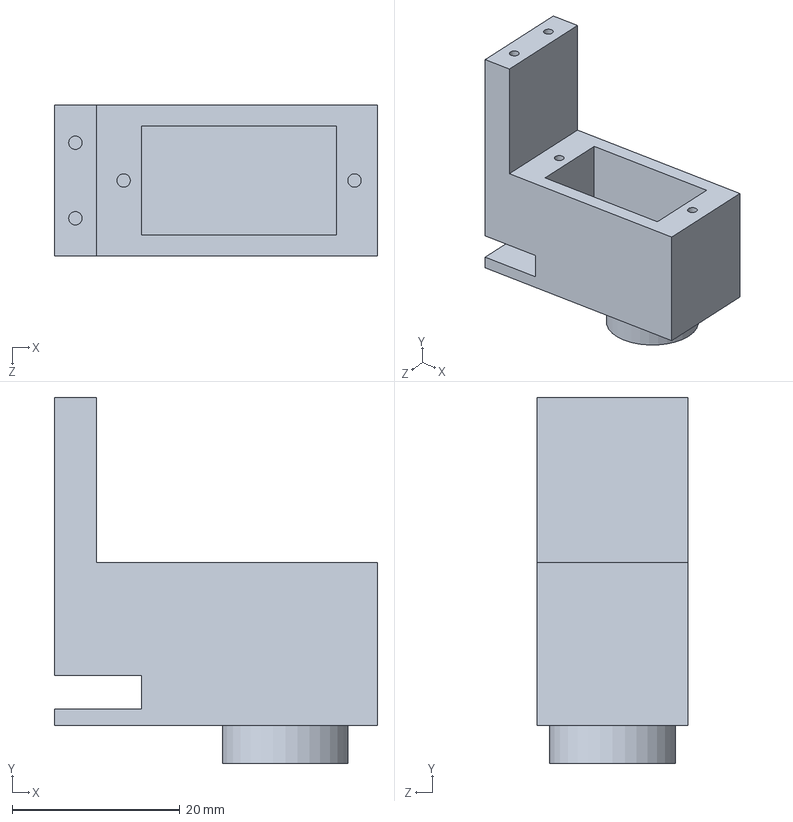
[picture p33: CAD file, 2026-10-31]
cad/joint_v01/Joint_Housing.SLDPRT
38.5 x 43.6 x 18.0 mm
