PogValGen/robo-boxer/cad/leg/Leg_Foot.SLDPRT

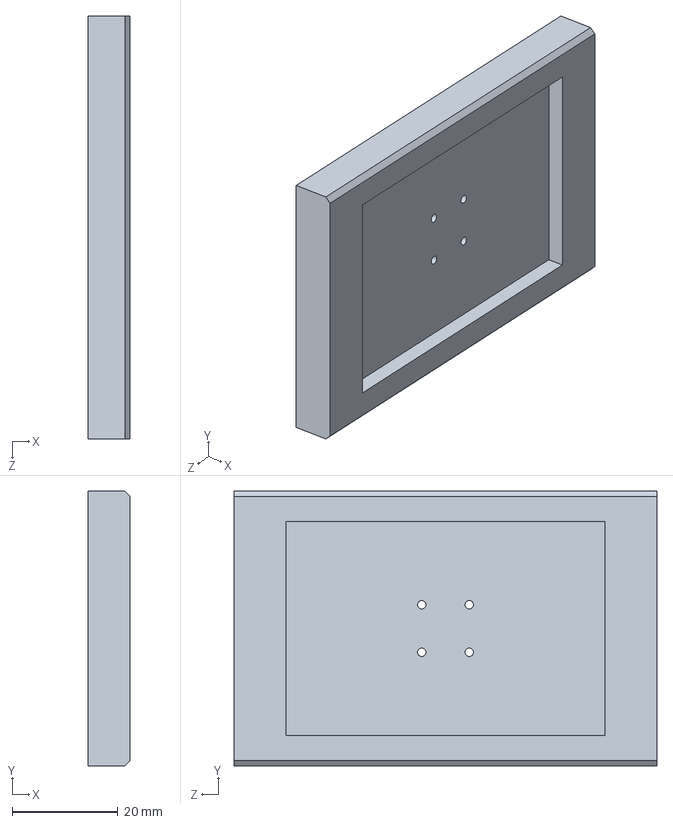
[picture p34: CAD file, 2026-10-31]
cad/leg/Leg_Foot.SLDPRT
8.00 x 52.0 x 80.0 mm
