PogValGen/robo-boxer/cad/arm/Fist_TPU.SLDPRT

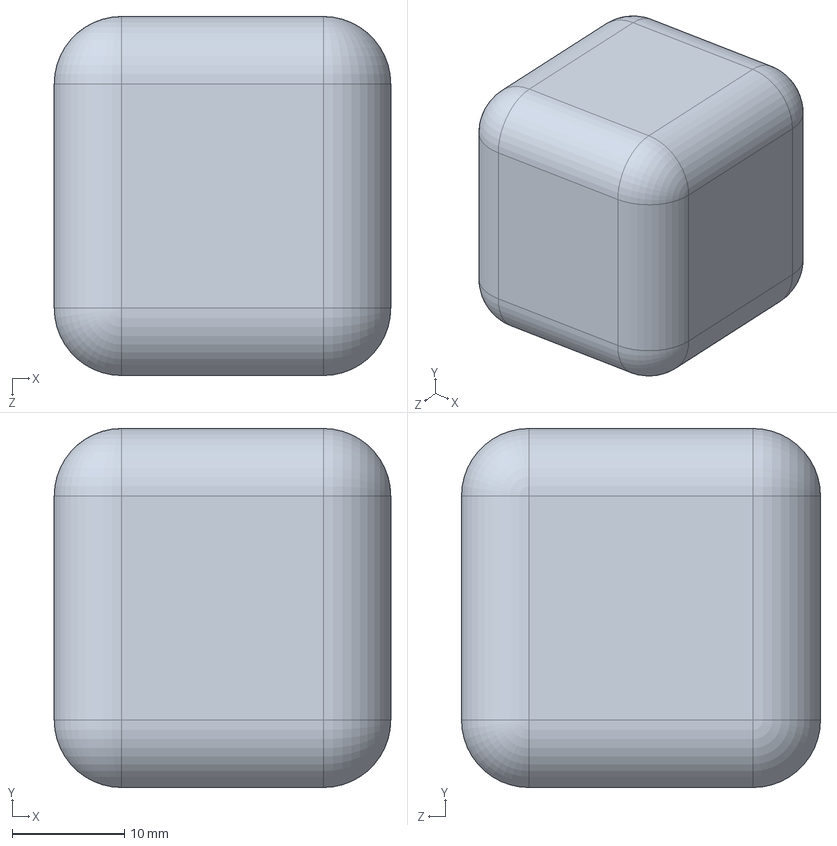
[picture p35: CAD file, 2026-10-31]
cad/arm/Fist_TPU.SLDPRT
30.0 x 32.0 x 32.0 mm
