PogValGen/robo-boxer/cad/body/Shoulder_Yoke.SLDPRT

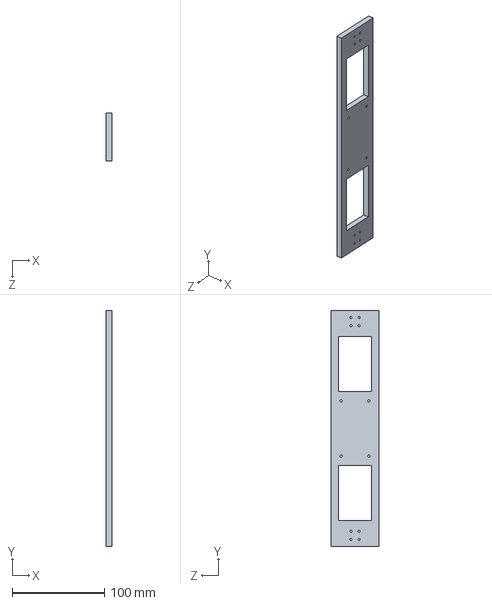
[picture p36: CAD file, 2026-10-31]
cad/body/Shoulder_Yoke.SLDPRT
6.00 x 256.0 x 52.0 mm
