PogValGen/robo-boxer/cad/joint/Joint_Housing.SLDPRT

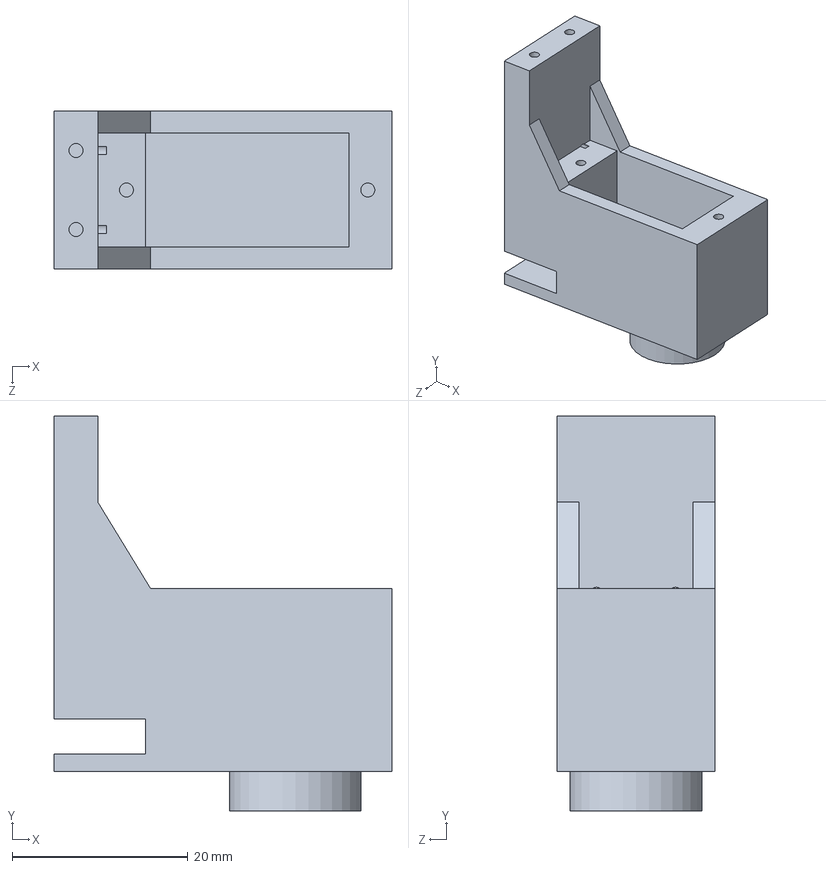
[picture p37: CAD file, 2026-10-31]
cad/joint/Joint_Housing.SLDPRT
38.5 x 45.0 x 18.0 mm
