PogValGen/robo-boxer/cad/joint_v01/Joint_Bridge.SLDPRT

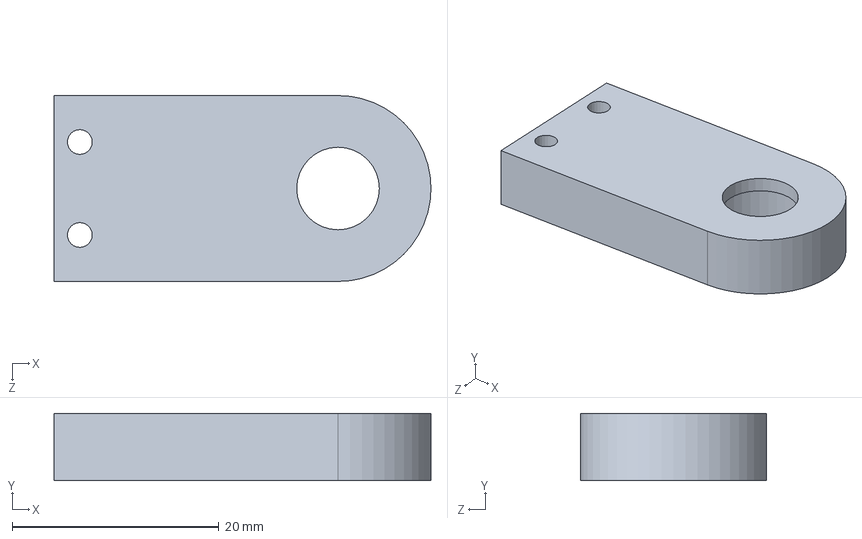
[picture p38: CAD file, 2026-10-31]
cad/joint_v01/Joint_Bridge.SLDPRT
36.5 x 6.50 x 18.0 mm
