PogValGen/robo-boxer/cad/body/Pelvis.SLDPRT

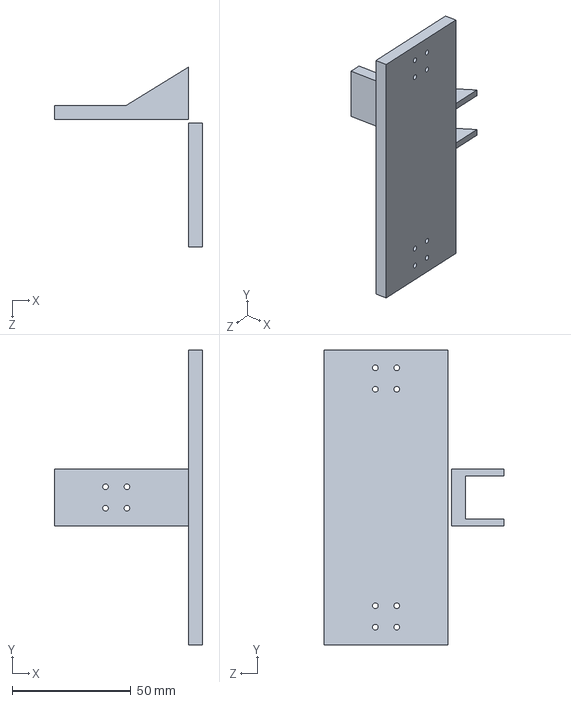
[picture p39: CAD file, 2026-10-31]
cad/body/Pelvis.SLDPRT
62.3 x 124.0 x 75.5 mm
