PogValGen/robo-boxer/cad/body/Torso_Mount.SLDPRT

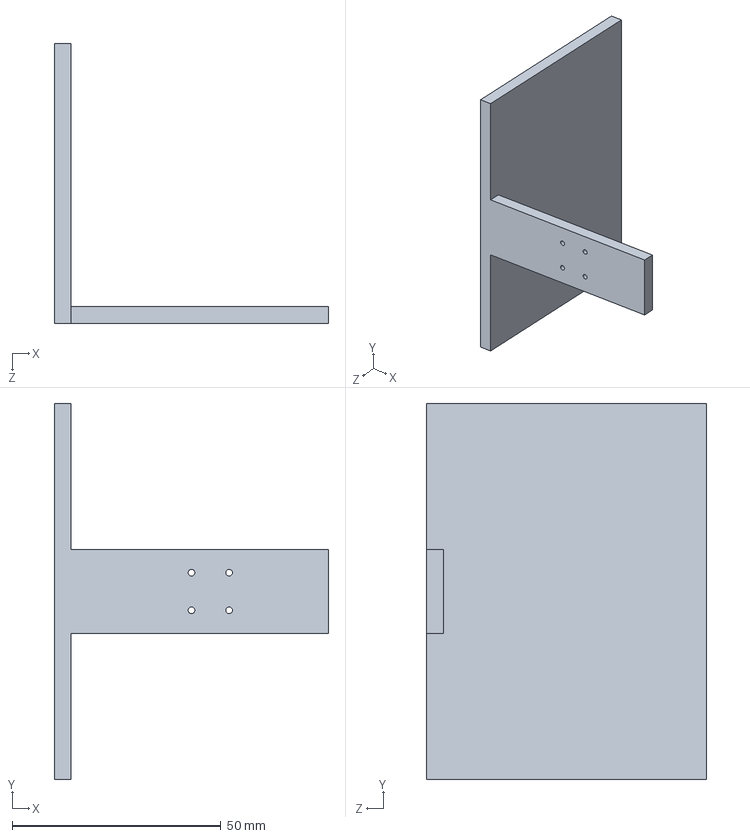
[picture p41: CAD file, 2026-10-31]
cad/body/Torso_Mount.SLDPRT
65.6 x 90.0 x 67.0 mm
