PogValGen/robo-boxer/cad/joint/Joint_Lever.SLDPRT

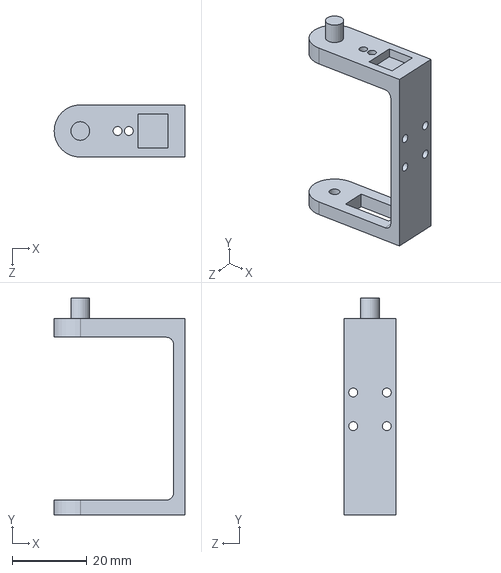
[picture p42: CAD file, 2026-10-31]
cad/joint/Joint_Lever.SLDPRT
35.0 x 58.1 x 14.0 mm
