PogValGen/robo-boxer/cad/joint_v01/Joint_Lever.SLDPRT

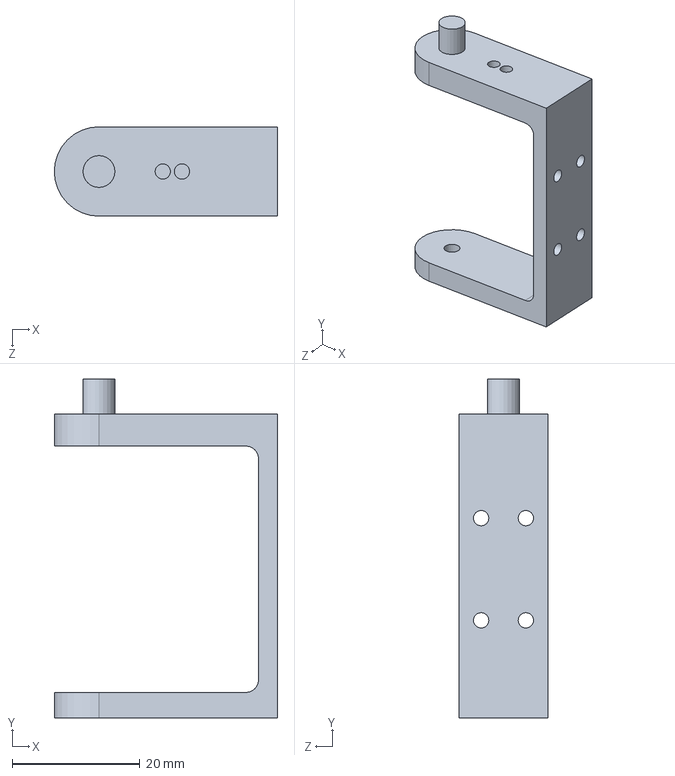
[picture p43: CAD file, 2026-10-31]
cad/joint_v01/Joint_Lever.SLDPRT
35.0 x 53.1 x 14.0 mm
