PogValGen/robo-boxer/(list of files, cad)

Other CAD files:
cad/joint_v01/MG90S_Horn.SLDPRT
cad/arm/stl/Fist_TPU.STL
cad/body/stl/Pelvis.STL
cad/body/stl/Shoulder_Yoke.STL
cad/body/stl/Torso_Mount.STL
cad/joint/stl/Joint_Bridge.STL
cad/joint/stl/Joint_Housing.STL
cad/joint/stl/Joint_Lever.STL
cad/leg/stl/Leg_Foot.STL
