PogValGen/robo-boxer/docs/notes/mg90s_measure_checklist.md

# MG90S — чеклист замеров (штангенциркуль, мм)

Положите сервопривод валом вверх, ушки горизонтально. Каждый размер — 2 замера, записать среднее в `cad/mg90s_params.json`.

| # | Ключ JSON | Что мерить | Куда ставить губки |
|---|---|---|---|
| 1 | `body_l` | длина корпуса без ушек | торцы корпуса вдоль ушек |
| 2 | `body_w` | ширина корпуса | боковые стенки поперёк |
| 3 | `body_h` | высота корпуса от дна до верхней крышки (без вала и «бугорка» редуктора) | дно – верхняя плоскость |
| 4 | `tab_span` | размах ушек | крайние торцы ушек |
| 5 | `tab_t` | толщина ушка | ушко насквозь |
| 6 | `tab_z` | высота нижней плоскости ушка от дна | дно – низ ушка (глубиномер) |
| 7 | `hole_pitch` | расстояние между центрами крепёжных отверстий ушек | край-край отверстий минус Ø |
| 8 | `hole_d` | диаметр крепёжного отверстия / ширина паза | внутренние губки |
| 9 | `shaft_x` | расстояние от оси вала до ближнего торца корпуса | торец – образующая вала + Ø/2 |
| 10 | `shaft_d` | наружный Ø шлицевого вала | по вершинам шлицев |
| 11 | `shaft_h` | вылет вала над верхней плоскостью корпуса | глубиномер |
| 12 | `boss_d`, `boss_h` | Ø и высота цилиндрического выступа вокруг вала | — |
| 13 | `teeth` | число зубьев шлица (посчитать по фото крупным планом) | — |
| 14 | `cable_x`, `cable_z` | место выхода кабеля (от торца, от дна) | — |

| 15 | `horn.hub_d`, `horn.hub_bottom_y` | Ø ступицы штатной одноплечей качалки; зазор ступица–выступ редуктора | — |
| 16 | `horn.plate_t`, `horn.arm_w`, `horn.arm_r` | толщина плеча, ширина у ступицы, длина от оси до конца | — |
| 17 | `horn.screw_r` | радиусы отверстий плеча, которые используем под саморезы | — |
| 18 | `cable.end` | из какого торца выходит кабель (со стороны вала или противоположного) и на какой высоте от дна | — |

После заполнения: `python scripts\build_joint.py` перестроит модель и узел.
